Takashi-Kamata/Air-Purifier/PCB/BOM.csv

ID | Name | Designator | Footprint | Quantity | Manufacturer Part | Manufacturer | Supplier | Supplier Part | Price
1 | ESP32_left_pin_header | U4 | FEMALE_HEADER_1X19 | 1
2 | ESP32_right_pin_header | U5 | FEMALE_HEADER_1X19 | 1
3 | BSS138 | Q1 | SOT23-3 | 1
4 | 10K | R6,R5 | 0603-RES | 2
5 | NODEMCU-32SLUA | U1 | COMM-TH_NODEMCU-32SLUA | 1 | NodeMCU-32SLua | Ai-Thinker(安信可) | LCSC | C111436
6 | 100nF | C1,C2 | C0603 | 2 | 0603F104M500NT | FH(风华) | LCSC | C42998 | 0.002
7 | 33nF | CFF | C0603 | 1 | CC0603KRX7R9BB333 | YAGEO(国巨) | LCSC | C106856 | 0.003
8 | 680uF | CIN | CAP-SMD_BD12.5-L13.0-W13.0-LS14.4-FD | 1 | VKML1701H681MV | Ymin(永铭) | LCSC | C487372 | 0.597
9 | 220uF | COUT | CAP-SMD_L7.3-W4.3-R-RD | 1 | TPSD227M010R0150 | Kyocera AVX | LCSC | C283236 | 0.546
10 | SSB43L-E3/52T | D1 | SMB_L4.6-W3.6-LS5.3-RD | 1 | SSB43L-E3/52T | VISHAY(威世) | LCSC | C222519 | 0.127
11 | 47uH | L1 | IND-SMD_L14.5-W13.0_SLO1365S | 1 | SLO1365S470MTT | Sunltech(韩国顺磁) | LCSC | C242230 | 0.457
12 | LM2596S-5.0/TR_C459077 | U2 | TO-263-5_L10.1-W8.7-P1.70-LS14.4-BR | 1 | LM2596S-5.0/TR | HGC(Huaguan Semicon) | LCSC | C459077 | 0.266
13 | BL-HUE35A-AV-TRE | LED1,LED2 | LED-0805 | 2 |  |  | LCSC | C84256 | 0.011
14 | 220 | R1,R2 | 0805 | 2 | RC0805JR-07220RL | YAGEO | LCSC | C114742 | 0.002
15 | DC-050-2.0-G | DC1 | DC-IN_DC-050-2.0-BB | 1 | DC-050-2.0-G | USAKRO(美韩) | LCSC | C521458 | 0.278
16 | Motor | MOTOR | CONN-TH_XH2.54-5P | 1 | XH2.54-5P 直插 | null | LCSC | C5359633 | 0.021
17 | SEN55 | SEN55 | CONN-TH_XH2.54-5P | 1 | XH2.54-5P 直插 | null | LCSC | C5359633 | 0.021
18 | Logic Shifter | LOGIC_SHIFTER | WJ300V-5.00-2P | 1 | WJ300V-5.0-2P | ReliaPro | LCSC | C8385 | 0.08
